eman8388/ETHlink8DAC/snapshot_device_example/ETHlink8xDAC_product_3.jpeg

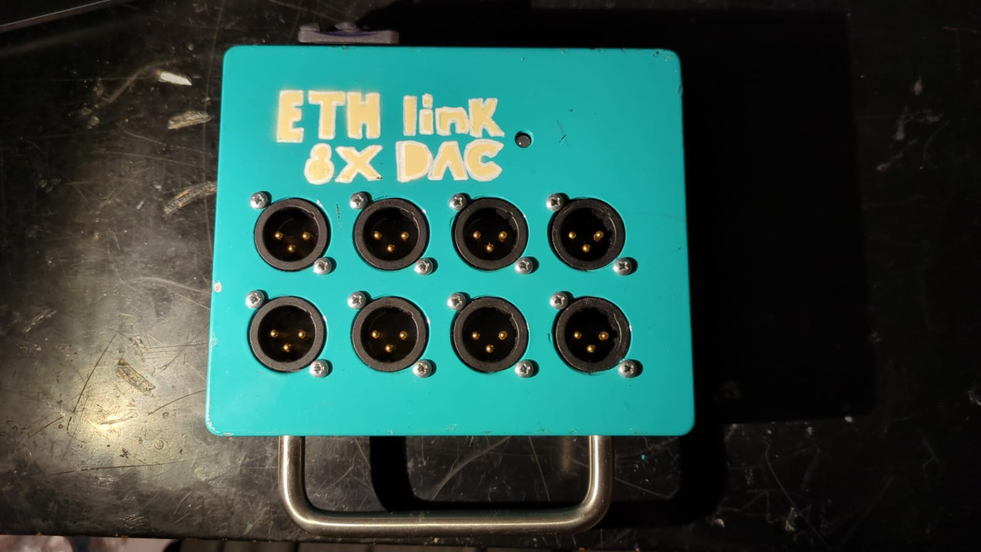
snapshot_device_example/ETHlink8xDAC_product_3.jpeg
