eman8388/ETHlink8DAC/snapshot_PCB/3D_ETHlink8xDAC_PCB_2.png

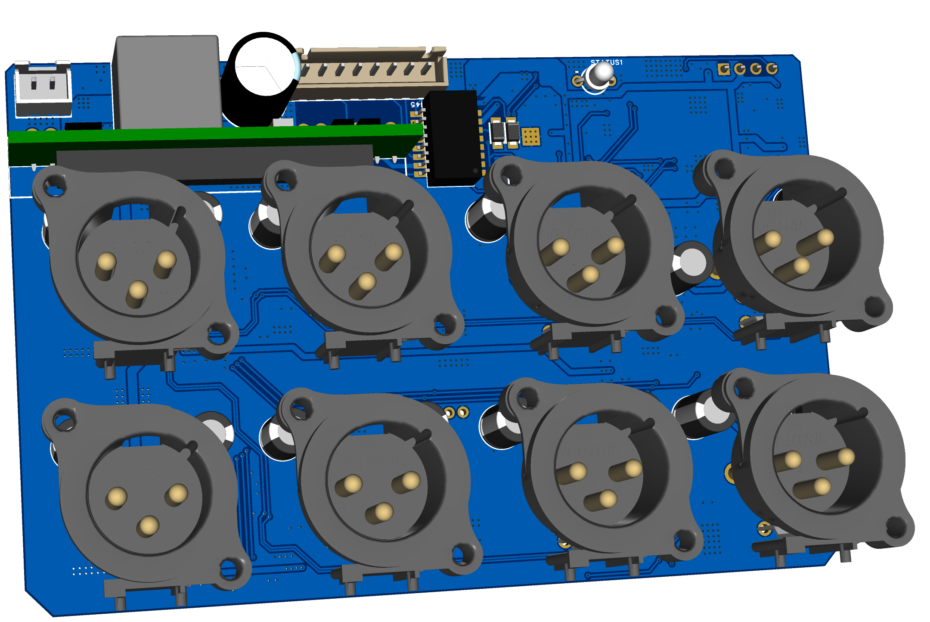
snapshot_PCB/3D_ETHlink8xDAC_PCB_2.png
