eman8388/ETHlink8DAC/PCB_BOM/BOM_ETHlink8xDAC_ETHlink8xDAC_PCB_2025-03-30.xlsx

No. | Comment | Designator | Footprint | Value | Manufacturer Part | Manufacturer | Supplier Part | Supplier | Quantity
1 | 10uF | C116,C119,C127,C129,C133,C136,C141,C143,C146,C149,C150,C158,C160,C163,C166,C167,C175,C177,C180,C183,C184,C185,C194,C195,C196,C197,C202,C203,C204,C215,C218,C224 | C0603 | 10uF | CL10A106MQ8NNNC | SAMSUNG(三星) | C1691 | LCSC | 32
2 | 100nF | C117,C124,C126,C128,C135,C140,C142,C148,C151,C157,C159,C165,C168,C174,C176,C182,C192,C193,C201,C214,C217,C223,C225,C230,C231,C232,C233,C234,C235,C236,C237 | C0603 | 100nF | CL10B104KC8NNNC | SAMSUNG(三星) | C15725 | LCSC | 31
3 | 860020773013 | C118,C120,C121,C123,C125,C131,C137,C139,C152,C153,C154,C156,C169,C170,C171,C173 | CAP-TH_BD6.3-P2.50-D0.5-FD |  | 860020773013 | Wurth(伍尔特) | C7046938 | LCSC | 16
4 | 2.2nF | C122,C132,C138,C145,C155,C162,C172,C179,C238 | C0603 | 2.2nF | GRM1885C1H222JA01D | muRata(村田) | C77033 | LCSC | 9
5 | 2.2uF | C130,C134,C144,C147,C161,C164,C178,C181,C228,C229 | C0603 | 2.2uF | CL10A225KA8NNNC | SAMSUNG(三星) | C57895 | LCSC | 10
6 | 1000uF | C198 | CAP-TH_BD10.0-P5.00-D1.0-FD | 1000uF | 25PK1000MEFC10*16 | rubycon(红宝石) | C109451 | LCSC | 1
7 | 1uF | C210,C216 | C0603 | 1uF | CL10A105KB8NNNC | SAMSUNG(三星) | C15849 | LCSC | 2
8 | 10pF | C219,C221 | C0603 | 10pF | CL10C100JB8NNNC | SAMSUNG(三星) | C1634 | LCSC | 2
9 | 470pF | C220 | C0603 | 470pF | CL10C471JC8NNNC | SAMSUNG(三星) | C525649 | LCSC | 1
10 | SS34 | D3 | SMA_L4.3-W2.6-LS5.2-RD |  | SS34 | MDD | C8678 | LCSC | 1
11 | 4.7uH | L1 | IND-SMD_L7.0-W6.6_0630CDMCCDS | 4.7uH | 0630CDMCDDS-4R7MC | Sumida(胜美达) | C2453469 | LCSC | 1
12 | PT61017PEL | L3 | XFMR-SMD_PT61017PEL |  | PT61017PEL | BOURNS | C124001 | LCSC | 1
13 | 1uH | L4 | L1008 | 1uH | LQM2HPN1R0MGHL | muRata(村田) | C162587 | LCSC | 1
14 | MHT192JGCT | LED1,LED2 | LED0603-RD |  | MHT192JGCT | MEIHUA(美华) | C473820 | LCSC | 2
15 | DP9700 at-12V2A | POE_MODULE1 | PWRM-TH_DP9700-XX |  | DP9700 at-12V2A | SDAPO(达普) | C5380092 | LCSC | 1
16 | ZX-XH2.54-2PZZ | PWR_EXT1 | CONN-TH_2P-P2.50_HX25003-2A |  | ZX-XH2.54-2PZZ | Megastar(兆星) | C7429632 | LCSC | 1
17 | 470Ω | R100,R101,R102,R105,R108,R109,R112,R113,R142,R143,R148,R149,R150,R151 | R0603 | 470Ω | 0603WAF4700T5E | UNI-ROYAL(厚声) | C23179 | LCSC | 14
18 | 4.7kΩ | R103,R104,R106,R107,R110,R111,R114,R115,R118,R119,R134,R136,R137,R138,R140 | R0603 | 4.7kΩ | 0603WAF4701T5E | UNI-ROYAL(厚声) | C23162 | LCSC | 15
19 | 10kΩ | R123,R144,R145,R146,R147 | R0603 | 10kΩ | RC0603FR-0710KL | YAGEO(国巨) | C98220 | LCSC | 5
20 | 33kΩ | R124 | R0603 | 33kΩ | 0603WAF4702T5E | UNI-ROYAL(厚声) |  | LCSC | 1
21 | 47Ω | R127,R128,R129,R130,R132,R133,R139,R141 | R0603 | 47Ω | 0603WAF470JT5E | UNI-ROYAL(厚声) | C23182 | LCSC | 8
22 | 12.1kΩ | R131 | R0603 | 12.1kΩ | 0603WAF1212T5E | UNI-ROYAL(厚声) | C22864 | LCSC | 1
23 | 1.5kΩ | R135 | R0603 | 1.5kΩ | 0603WAF1501T5E | UNI-ROYAL(厚声) | C22843 | LCSC | 1
24 | B8B-XH-AM | RJ45 | CONN-TH_8P-P2.50_B8B-XH-AM-LF-SN |  | B8B-XH-AM | JST | C5306535 | LCSC | 1
25 | 209UYSYGW/S530-A3/R2 | STATUS1 | LED-TH_3P-BD4.0-P2.54 |  | 209UYSYGW/S530-A3/R2 | EVERLIGHT(亿光) | C409519 | LCSC | 1
26 | HB-PH3-25414PB2GOP | SW1 | HDR-TH_4P-P2.54-V-M |  | HB-PH3-25414PB2GOP | HANBO(汉博) | C6332197 | LCSC | 1
27 | PCM5122PW | U12,U13,U14,U15 | TSSOP-28_L9.8-W6.6-P0.65-BL |  | PCM5122PW | TI(德州仪器) | C1540085 | LCSC | 4
28 | SI5351A-B-GTR | U16 | MSOP-10_L3.0-W3.0-P0.50-LS5.0-BL |  | SI5351A-B-GTR | SKYWORKS/SILICON LABS(芯科) | C504891 | LCSC | 1
29 | STM32H743VIT6 | U17 | LQFP-100_L14.0-W14.0-P0.50-LS16.0-BL |  | STM32H743VIT6 | ST(意法半导体) | C529058 | LCSC | 1
30 | AP62300WU-7 | U18 | TSOT-23-6_L2.9-W1.6-P0.95-LS2.8-BL |  | AP62300WU-7 | DIODES(美台) | C1880390 | LCSC | 1
31 | LD39200PUR | U19,U20 | DFN-6_L3.0-W3.0-P0.95-BL-EP-1 |  | LD39200PUR | ST(意法半导体) | C2969757 | LCSC | 2
32 | LAN8742A-CZ | U22 | QFN-24_L4.0-W4.0-P0.50-BL-EP2.6 |  | LAN8742A-CZ | MICROCHIP(美国微芯) | C220794 | LCSC | 1
33 | MMSZ5228B | U23,U24,U25,U26 | SOD-123_L2.8-W1.8-LS3.9-FD |  | MMSZ5228B | 宏迦橙 | C22399895 | LCSC | 4
34 | 25MHz | X1,X2 | CRYSTAL-SMD_4P-L3.2-W2.5-BL | 25MHz | 7M-25.000MEEQ-T | TXC(晶技) | C2450106 | LCSC | 2
35 | NC3MAAV | XLR9,XLR10,XLR11,XLR12,XLR13,XLR14,XLR15,XLR16 | CONN-TH_NC3MAAV |  | NC3MAAV | NEUTRIK(优曲克) | C368456 | LCSC | 8
