eman8388/ETHlink8DAC/(list of files, drawings)

Other design files:
PCB_EasyEDAPro_PROJECT/ProPrj_ETHlink8DAC_V1.0.epro
